upenn-embedded/final-project-s26-t2/README.md

Review Assignment Due Date (https://classroom.github.com/a/-Acvnhrq)

# Final Project

**Team Number: T2**

**Team Name:**

| Team Member Name | Email Address |
| --- | --- |
| Marko Mijatovic  | markomij@seas.upenn.edu |
| Devan Malik | devmalik@seas.upenn.edu |
| Kim Huang | huangkim@seas.upenn.edu |
| Victor Wanjohi | vwanjohi@seas.upenn.edu |

**GitHub Repository URL:  [https://github.com/upenn-embedded/final-project-s26-t2]([https://github.com/upenn-embedded/final-project-s26-t2]())**

**GitHub Pages Website URL:** https://devmalik771.github.io/Friendly_Fire/

## Final Project Proposal

### 1. Abstract

This project is a self-contained infrared laser tag system built around two ATmega328PB microcontrollers running bare-metal C. The system consists of a handheld blaster that transmits coded IR packets, a wearable vest that detects and validates hits with audiovisual feedback, and a Bluetooth-linked web application that serves as a referee console for match control and live scoring. The blaster features an LCD display (SPI) for ammo tracking, an MPU6050 accelerometer (I2C) enabling a shake-to-reload gesture, and sound effects via a piezo buzzer. The vest uses multiple IR receivers for coverage, RGB LEDs for hit and health feedback, and communicates match state to the web app over BLE. Together, the system enables a full match loop: start, play, elimination, winner declaration, and reset.

### 2. Motivation

Laser tag is a proven recreational concept, but commercial systems are expensive, proprietary, and offer no insight into the engineering behind them. This project recreates a fully functional laser tag experience from scratch using embedded systems principles, providing a hands-on application of IR communication, real-time firmware state machines, serial peripherals, and wireless connectivity. The project is interesting because it integrates multiple complex subsystems (shooting, hit detection, game logic, wireless comms, and a user-facing web interface) into a single playable product. The intended purpose is a two-player laser tag demo that can run a complete match cycle in under two minutes, showcasing real-time embedded system design at the ESE 3500 final demo day.

### 3. System Block Diagram



The system is composed of three subsystems communicating through IR and BLE:

Blaster (MCU 1 — ATmega328PB): Trigger and reload buttons (GPIO with internal pull-ups and pin-change interrupts), IR LED emitter driven through an NPN transistor (2N2222) switching 100 mA, modulated at 38 kHz via Timer1 output compare, SPI-driven ST7735 LCD breakout (128x160, onboard 3.3V level shifter), MPU6050 IMU breakout over I2C at 400 kHz (onboard LDO and level shifter for 5V-safe operation), piezo buzzer (Timer0 PWM), and a shoot-indicator LED with 220-ohm current-limiting resistor. Powered by a USB power bank providing 5V directly (no voltage regulator needed). 100 nF decoupling capacitors on MCU VCC pins.

Vest (MCU 2 — ATmega328PB): Two TSOP38238 IR receivers (5V-tolerant output, connected via pin-change interrupts for hit detection), WS2812B RGB LED strip (5V, 800 kHz data line), piezo buzzer (Timer2 PWM), and an HM-10 BLE module (3.3V logic) connected through a bidirectional logic level shifter on UART TX/RX lines at 9600 baud. The vest MCU runs game state logic (health tracking, invulnerability windows, elimination detection) and reports status to the web app via BLE. Powered by a USB power bank providing 5V directly. 100 nF decoupling capacitors on MCU VCC pins.

Web App (Referee Console): A browser-based application using the Web Bluetooth API that connects to the vest's BLE module. Provides match start/reset commands and displays live player health, ammo (relayed), hit events, and winner/loser at match end.

Communication Protocols

IR (Gun → Vest): 38 kHz modulated carrier with NEC-style packet encoding (preamble + shooter ID + team ID + CRC)

SPI (MCU 1 → LCD): ST7735 display driven over hardware SPI

I2C (MCU 1 → MPU6050): Accelerometer/gyroscope for shake-to-reload gesture detection on the blaster

UART (MCU 2 → HM-10 BLE): Serial link at 9600 baud through a bidirectional 5V/3.3V logic level shifter

GPIO + Interrupts: Button inputs (trigger, reload), IR receiver hit detection via pin-change interrupts

Topics Covered

Timers: PWM for IR carrier generation (38 kHz), buzzer tones, and LED brightness/patterns

Interrupts: Button debouncing, IR receiver packet detection, timer overflow for game timing

Serial Communication (SPI + I2C + UART): LCD display over SPI, MPU6050 accelerometer over I2C, BLE module over UART (satisfies I2C/SPI requirement with both protocols)

(Advanced) Wireless Communication: IR shot protocol design + BLE connectivity for remote match control

### 4. Design Sketches

#### Blaster



Handheld enclosure (3D printed or laser-cut) housing the ATmega328PB on perfboard, IR LED at the barrel tip driven by a 2N2222 NPN transistor, trigger and reload buttons on the grip, an ST7735 LCD breakout on the back face visible to the shooter, an MPU6050 IMU breakout mounted inside for shake-to-reload detection, a piezo buzzer, and a shoot-indicator LED. Powered by a USB power bank (5V direct, no regulator needed). Decoupling capacitors on all IC power pins.

#### Vest



A fabric vest or harness with 3D-printed/laser-cut mounting points for two IR receivers (front and back), WS2812B RGB LEDs for hit feedback visible to other players, a piezo buzzer for audio cues, and a small enclosure for the ATmega328PB, bidirectional level shifter, and HM-10 BLE module. Powered by a USB power bank (5V direct).



#### Manufacturing

3D printing (Tangen Hall / RPL): blaster enclosure, vest sensor mounts

Laser cutting (RPL): potential flat panels for enclosure sides, vest backing plate

### 5. Software Requirements Specification (SRS)

**5.1 Definitions, Abbreviations**

IR: Infrared. BLE: Bluetooth Low Energy. CRC: Cyclic Redundancy Check. PWM: Pulse Width Modulation. SPI: Serial Peripheral Interface. I2C: Inter-Integrated Circuit. UART: Universal Asynchronous Receiver-Transmitter. IMU: Inertial Measurement Unit. HRS: Hardware Requirements Specification. LCD: Liquid Crystal Display. MCU: Microcontroller Unit.e

**5.2 Functionality**

| ID | Description |
| --- | --- |
| SRS-01 | The blaster firmware shall transmit a valid IR shot packet within 50 ms of a trigger press, containing a preamble, shooter ID (4 bits), team ID (2 bits), and CRC-8 checksum. |
| SRS-02 | The blaster firmware shall enforce a minimum inter-shot interval of 500 ms (±50 ms) to prevent shot spamming, blocking trigger input during the cooldown period. |
| SRS-03 | The blaster firmware shall decrement the ammo counter on each valid shot and block firing when ammo reaches zero. The LCD shall update the displayed ammo count within 100 ms of a shot. |
| SRS-04 | The reload mechanic shall support two modes: (a) a continuous 10-second (±0.5 s) button hold, or (b) a shake-to-reload gesture detected by the MPU6050 (see SRS-09). For button reload, releasing early shall cancel the attempt. Successful reload via either method shall reset ammo to the maximum value. |
| SRS-05 | The vest firmware shall validate incoming IR packets by checking carrier frequency presence, correct packet framing, and CRC integrity. Invalid packets shall be discarded without affecting game state. |
| SRS-06 | Upon a valid hit, the vest firmware shall enforce an invulnerability window of 2 seconds (±200 ms) during which additional hits are ignored, preventing double-counting from a single shot burst. |
| SRS-07 | The vest firmware shall transmit updated player status (health, eliminated flag) to the BLE module via UART within 500 ms of any game state change (hit received, elimination, reset). |
| SRS-08 | Upon receiving a RESET command from the web app via BLE, both MCUs shall return to their initial ready state (full health, full ammo, ALIVE status) within 1 second. |
| SRS-09 | The blaster firmware shall read the MPU6050 accelerometer via I2C at a minimum rate of 20 Hz and detect a shake-to-reload gesture when acceleration exceeds 2g on any axis for at least 3 consecutive samples. The gesture shall initiate the reload sequence as an alternative to the button hold. |

### 6. Hardware Requirements Specification (HRS)

**6.1 Definitions, Abbreviations**

FOV: Field of View. dB: Decibels. SNR: Signal-to-Noise Ratio. PCB: Printed Circuit Board. LDO: Low Dropout Regulator. NPN: Negative-Positive-Negative (transistor type). BSS138: N-channel MOSFET used in level shifter circuits.

**6.2 Functionality**

| ID | Description |
| --- | --- |
| HRS-01 | The IR emitter circuit shall use an NPN transistor (2N2222 or equivalent) to drive a 940 nm IR LED at 100 mA, producing a 38 kHz (±1 kHz) modulated carrier signal detectable by a TSOP38238 receiver at a minimum range of 3 meters in indoor ambient lighting conditions. |
| HRS-02 | The vest shall incorporate a minimum of two IR receiver modules (TSOP38238 or equivalent) providing front and rear hit detection coverage. |
| HRS-03 | The LCD display (ST7735 or equivalent, minimum 128x128 pixels, SPI interface) shall be visible to the player under normal indoor lighting and update at a minimum refresh rate of 5 fps for game state information. |
| HRS-04 | The HM-10 BLE module (3.3V logic) shall connect to the vest MCU (5V logic) through a bidirectional logic level shifter on UART TX/RX lines at 9600 baud, and sustain a BLE link to the web app at distances up to 5 meters indoors.7. Bill of Materials (BOM) |
| HRS-05 | The piezo buzzers on both the blaster and vest shall produce audible feedback at a minimum of 65 dB at 30 cm distance, with distinct tones for shot fired, hit received, elimination, and reload complete events.HRS-06**HRS-06****HRS-06** |
| HRS-06 | The blaster and vest shall each be powered by USB power banks providing 5V directly, with a minimum capacity of 5000 mAh supporting at least 60 minutes of continuous gameplay without requiring a recharge. |
| HRS-07 | Each ATmega328PB shall operate at 16 MHz with a 5V supply from the USB power bank. Each MCU VCC pin shall have a 100 nF ceramic decoupling capacitor to filter high-frequency noise. Total system current draw per subsystem shall not exceed 500 mA. |
| HRS-08 | The LED feedback system on the vest shall provide visually distinct patterns for hit (flash), low health (pulsing), and eliminated (solid or rapid flash) states, visible from at least 2 meters in normal indoor lighting. |
| HRS-09 | The MPU6050 IMU shall be mounted rigidly inside the blaster enclosure and communicate with the ATmega328PB over I2C at 400 kHz. The accelerometer shall be configured for a ±4g range with 16-bit resolution. |

### 7. Bill of Materials (BOM)

| Component | Part / Model | Qty | Unit Cost | Vendor | Purpose |
| --- | --- | --- | --- | --- | --- |
| Microcontroller | ATmega328PB | 2 | Kit | Lab / Kit | Blaster + Vest MCUs |
| LCD Display | ST7735 1.8" TFT breakout (SPI, onboard level shifter) | 1 | ~$10 | Adafruit | Blaster ammo display |
| IMU | MPU6050 breakout (I2C, onboard LDO + level shifter) | 1 | ~$4 | Adafruit | Shake-to-reload gesture |
| IR Emitter LED | 940nm IR LED (5mm) | 2 | ~$1 | Adafruit / DigiKey | Shot transmission |
| NPN Transistor | 2N2222 + 100Ω base resistor | 2 | ~$0.50 | Lab / DigiKey | IR LED driver (100mA) |
| IR Receiver | TSOP38238 (38kHz) | 3–4 | ~$2 ea | Adafruit / DigiKey | Vest hit detection |
| BLE Module | HM-10 (3.3V UART) | 1 | ~$6 | Amazon / Adafruit  | Vest-to-web-app link |
| Logic Level Shifter | Bi-dir 3.3V/5V (BSS138) | 1 | ~$4 | Adafruit | UART level shift for HM-10 |
| Piezo Buzzer | Passive piezo | 2 | ~$1 ea | Adafruit / DigiKey | Audio feedback |
| RGB LEDs | WS2812B strip | 1 strip | ~$8 | Adafruit | Vest hit/health feedback |
| Buttons | Tactile pushbuttons | 3–4 | ~$0.50 ea | Lab / DigiKey | Trigger, reload, reset |
| USB Power Banks | 5V 2A output, 5000mAh+ | 2 | ~$8 ea | Amazon | 5V power for each unit |
| Passives + Misc | 100nF caps, 220Ω/100Ω resistors, perfboard, wires | — | ~$10 | Lab / Kit | Decoupling, current limiting, assembly |

Estimated Total: ~$70–$90

### 8. Final Demo Goals

On demo day, the system will be demonstrated as a live two-player laser tag match at a lab station in Detkin Lab. One team member will wear the vest and another will hold the blaster while someone else operates the web app on a laptop as the referee. The demo will follow this sequence:

* Referee starts the match from the web app
* Player fires the blaster at the vest, showing IR hit detection, LCD ammo decrement, and vest LED/buzzer feedback in real time
* Player runs out of ammo and performs the shake-to-reload gesture (or 10-second button hold as fallback)
* Vest player is eliminated (health reaches zero), vest shows elimination feedback, web app declares result
* Referee resets the match from the web app, all devices return to ready state

#### Constraints

* Demo will be conducted at a single lab station (no outdoor space required)
* IR range of ~3 meters is sufficient for the indoor demo area
* All components are USB power bank powered for portability (no wall outlet dependency)

### 9. Sprint Planning

**Sprint Milestones**

| Week | Milestone | Key Tasks |
| --- | --- | --- |
| Mar 16–22 | Parts Ordering + Prototyping | Finalize BOM, order parts, begin breadboard prototyping of IR emitter/receiver pair, set up ATmega328PB dev environments |
| Mar 23–30 | Subsystem Bringup | IR TX/RX communication working, LCD displaying over SPI, BLE module pairing with test web page, buzzer tones verified. Parts ordering meeting with Account Manager. |
| Mar 30–Apr 3 | Sprint 1: Core Firmware | Blaster state machine (ammo, fire, reload), vest state machine (health, hits, invulnerability). IR packet protocol (encode/decode + CRC). Sprint Review #1. |
| Apr 4–10 | Sprint 2: Integration | Integrate blaster and vest for end-to-end shot-hit cycle. BLE commands from web app controlling game state. Begin mechanical enclosure work. Sprint Review #2. |
| Apr 11–17 | MVP Demo | All electronics and firmware functional at basic level. Full match loop working (start, shoot, hit, eliminate, reset). Enclosures in progress. MVP Demo on Apr 17.  |
| Apr 18–24 | Polish + Final Demo | Finalize enclosures, polish web app UI, tune IR range/reliability, stress test full system. Final Demo Apr 24. |
| Apr 25–27 | Final Report | Record demo video, write validation results for SRS/HRS, complete GitHub Pages website. Due Apr 27. |

| Member | Primary Responsibility | Secondary |
| --- | --- | --- |
| Kim | Blaster firmware (state machine, IR TX, LCD driver) | IR protocol co-design |
| Devan  | Vest firmware (hit detection, game logic, BLE UART) | IR protocol co-design |
| Marko  | Web app (BLE integration, match UI, referee controls) | BLE protocol definition, integration testing |
| Victor | Hardware & mechanical (circuits, power, enclosures, vest) | Integration, soldering, 3D print / laser cut |

**This is the end of the Project Proposal section. The remaining sections will be filled out based on the milestone schedule.**

## Sprint Review #1

### Last week's progress

**Blaster (MCU 1) — Kim & Victor:**

- Trigger and reload buttons wired with GPIO and internal pull-ups, confirmed functional on breadboard.
- IR emitter circuit assembled: 940nm IR LED driven through 2N2222 NPN transistor, switching ~100mA off a GPIO-controlled base pin.
- ATmega328PB dev environment set up and running bare-metal C on the blaster MCU.
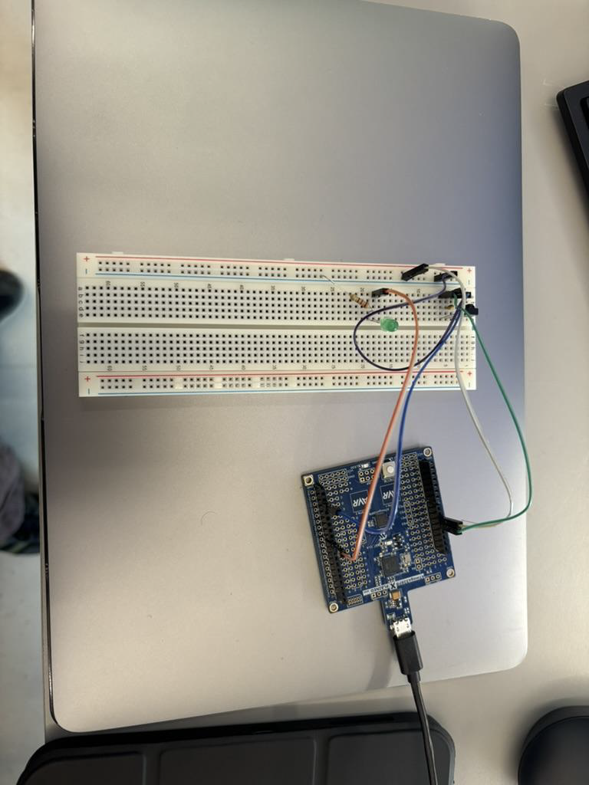
[picture p1: image/README/1776045404980.png]
  

**Vest (MCU 2) — Devan & Marko:**

- TSOP38238 IR receiver wired with 100nF decoupling cap on VCC (required by datasheet for stable operation). Confirmed it detects 38kHz modulated IR from the blaster emitter.
- Basic hit detection prototype working: LED lights on valid IR detection via pin-change interrupt.
- Vest ATmega328PB brought up on the breadboard.

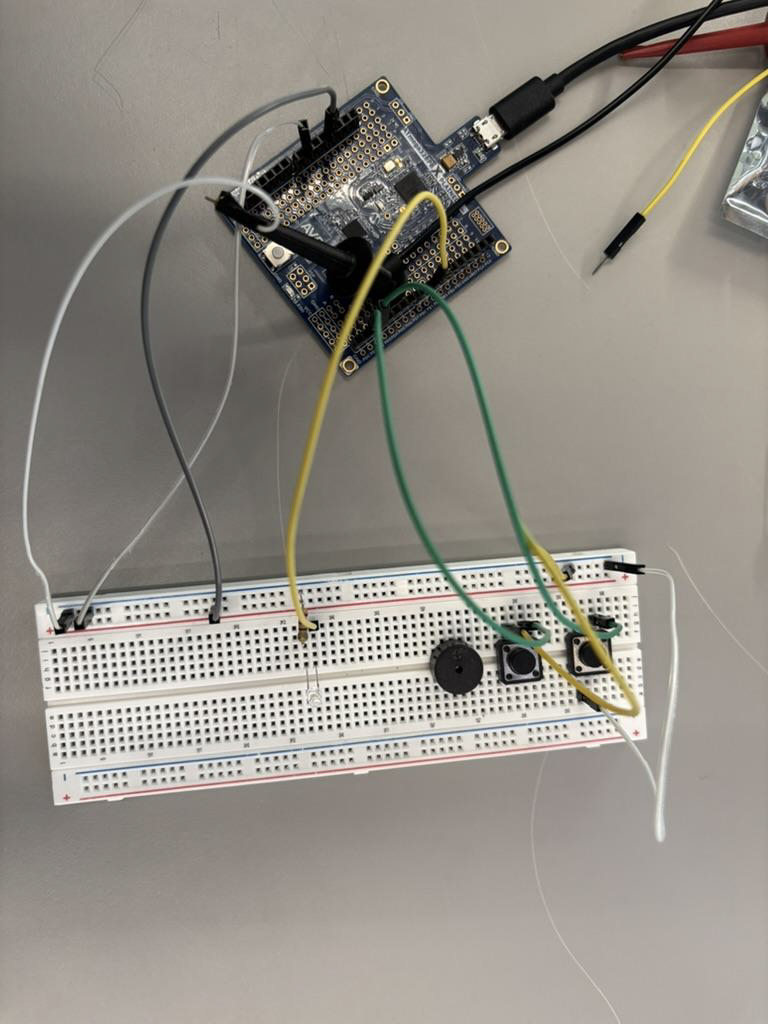
[picture p2: image/README/1776045441887.png]


Design Change — BLE → Feather ESP32:

- Pivoted from the HM-10 BLE module to an Adafruit Feather ESP32 for the wireless link between the vest and web app. The Feather gives us Wi-Fi + BLE flexibility and a more mature software ecosystem for the web app side, while still only serving as a comms module (no application logic — all game logic remains on the ATmega328PB per course restrictions).

### Current state of project

Core subsystems are individually coming online on breadboards. IR TX → RX link is proven at the physical layer. The BLE-to-Feather pivot is a scope adjustment but doesn't affect the ATmega firmware architecture — the Feather just replaces the HM-10 on the UART lines.

Hardware status: All critical components are in hand (ATmega328PBs, TSOP38238s, IR LEDs, 2N2222s, ST7735 LCD, MPU6050). Feather ESP32 is on hand. No outstanding part orders blocking progress.

Risk: IR packet reliability at 3m range hasn't been tested yet — that's a key validation target for next sprint.

### Next week's plan

| Task | Time  | Owner | Definition of Done |
| --- | ----- | --- | --- |
| Feather ESP32 + Web App BLE link | 2-4 h | Marko | Feather pairs with browser via Web Bluetooth API; can send/receive test strings bidirectionally |
| ST7735 LCD over SPI | 1-2 h | Kim | LCD displays static ammo count on blaster MCU |
| MPU6050 I2C bringup | 1-2 h | Kim/Devan | Read raw accelerometer values over I2C at 400kHz, print to serial |
| Piezo buzzer tones | 10 m  | Victor | Timer-driven PWM produces distinct tones for shot/hit/reload events |
| Migrate to circuit boards (perfboard) | 2 h | Victor/Devan/Marko | Blaster and vest circuits soldered on perfboard, off breadboard |

## Sprint Review #2

### Last week's progress

##### Blaster (MCU 1)

- Successfully demonstrated reload action sequences to the account manager.

##### Vest (MCU 2)

- Implemented piezo buzzer overtone generation via timer-driven PWM.
- Source code committed and pushed to the team GitHub repository.
- Successfully demonstrated distinct audio tones for shot, hit, and reload events to the account manager during lab session.
- Feather pairs with browser via Web Bluetooth API; can send/receive test strings bidirectionally

### Current state of project

### Next week's plan

## MVP Demo

### 1. Block Diagram:

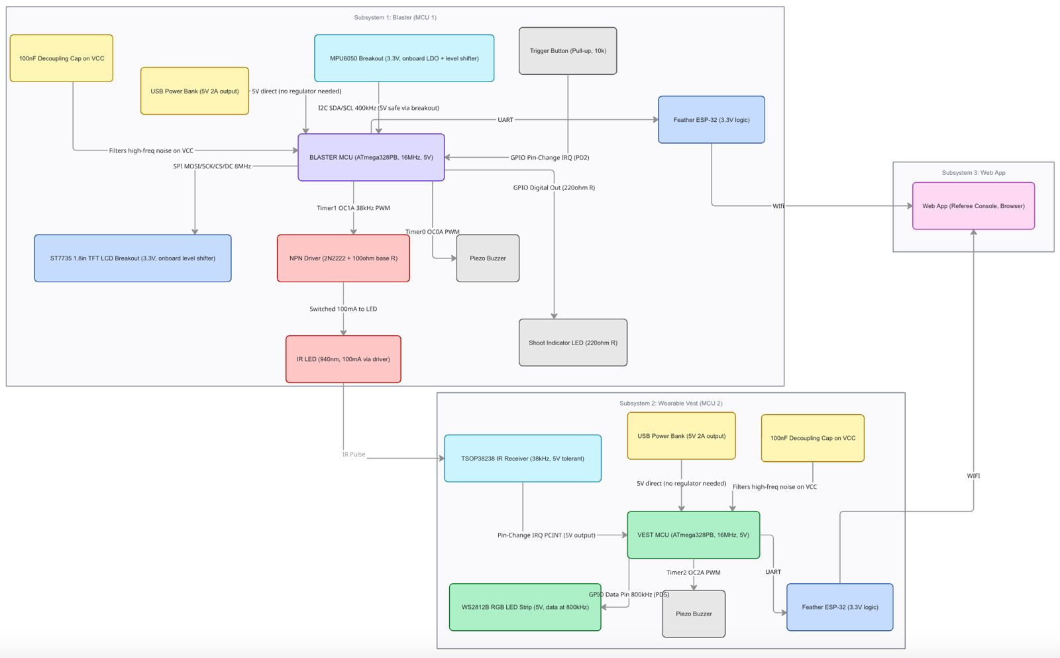
[picture p3: image/README/1777425051182.png]


Two ATmega328P MCUs,  one handles user input, LCD feedback, and IR transmission; the other detects incoming IR and signals a hit via LED flash.

### 2. Explain your firmware implementation, including application logic and critical drivers you've written.

We established UART communication between the main MCU and the Feather module, defined a simple message protocol, and enabled remote reset commands and periodic status updates to the web app.

We implemented a state machine to manage gameplay states (idle, firing, hit detection, reload, reset) and non-blocking timing via timers and interrupts to allow concurrent subsystem operation.

At demo, the system was fully playable ,a user could fire the blaster, register hits on the vest, receive feedback, and reset the game through the web interface.

### 3. Demo your device.

1. Power on → LCD shows `READY`, ammo = 12
2. Pull trigger → LCD shows `FIRED`, ammo decrements
3. Fire until empty → LCD shows `EMPTY`, further triggers blocked
4. Press reload → LCD shows `RELOADING` (1.5s) → resets to `READY`, ammo = 12
5. Fire at receiver → hit LED flashes 200ms

### 4. Have you achieved some or all of your Software Requirements Specification (SRS)?

| Requirement | Status |
| --- | --- |
| Display ammo count on startup | Done |
| Decrement ammo on valid trigger  | Done |
| Block firing at 0 ammo | Done |
| Show `EMPTY` when out of ammo  | Done |
| Show `RELOADING` during reload | Done |

### 5. Have you achieved some or all of your Hardware Requirements Specification (HRS)?

| Requirement | Status |
| --- | --- |
| IR LED transmitter on PC0 | Done |
| SPI LCD (ST7735) integrated  | Done |
| Trigger button on PD2 | Done |
| Reload button on PD3 | Done |
| TSOP38238 IR receiver on PD2 | Done |
| Hit indicator LED on PB0 | Done |

### 6. Show off the remaining elements that will make your project whole: mechanical casework, supporting graphical user interface (GUI), web portal, etc.

- **Mechanical casework** — rectangular blaster housing

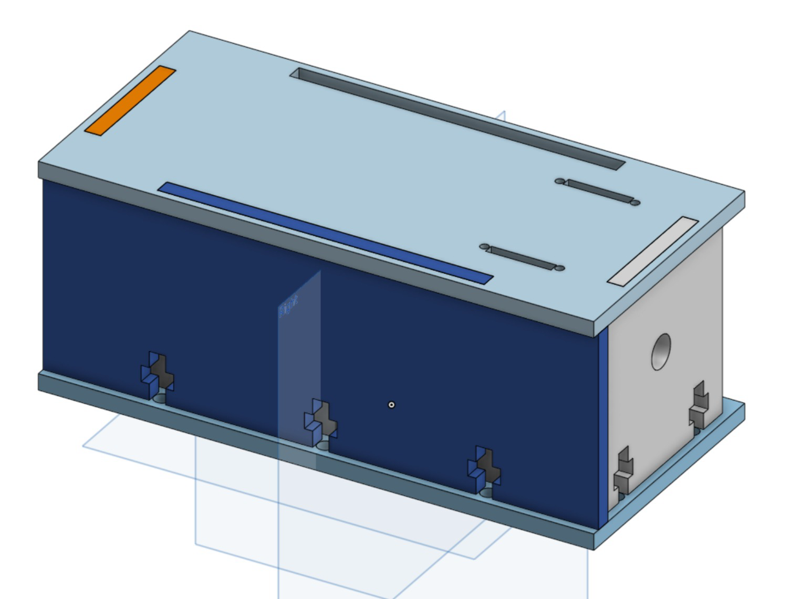
[picture p4: image/README/1776835262604.png]
  

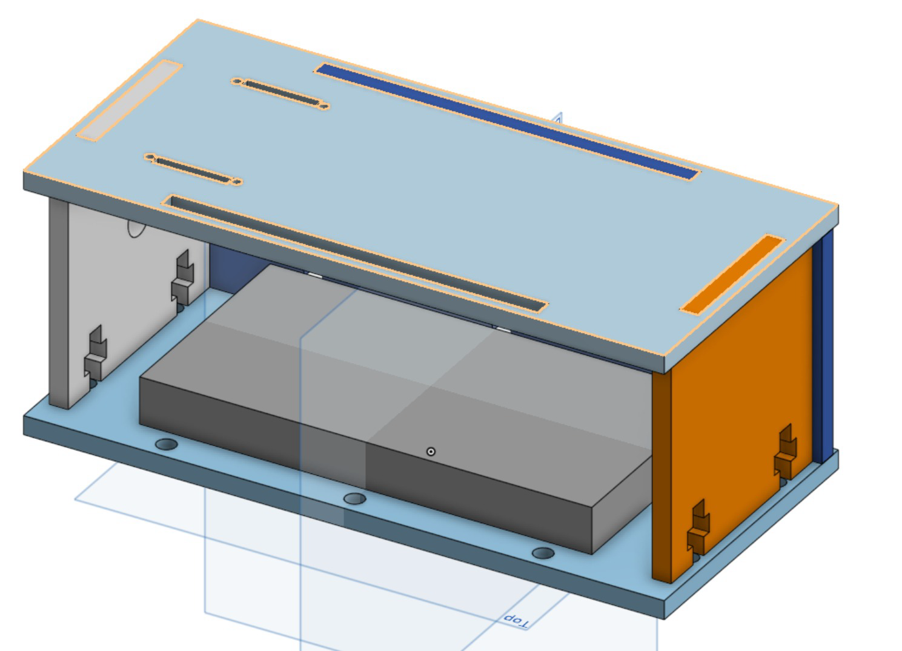
[picture p5: image/README/1776835277516.png]
  

### 7. What is the riskiest part remaining of your project?

During integration and migrating parts from breadboards to perfboards, some functionality might break down. We expect to solve all bugs in good time.

## Final Report

Don't forget to make the GitHub pages public website!
If you’ve never made a GitHub pages website before, you can follow this webpage (though, substitute your final project repository for the GitHub username one in the quickstart guide):  [https://docs.github.com/en/pages/quickstart](https://docs.github.com/en/pages/quickstart)

## 1. Video

https://drive.google.com/drive/folders/1jIbaAgMy6JAKm02dPGXfAoZNbYtTDbEu?usp=drive_link

### 2. Images

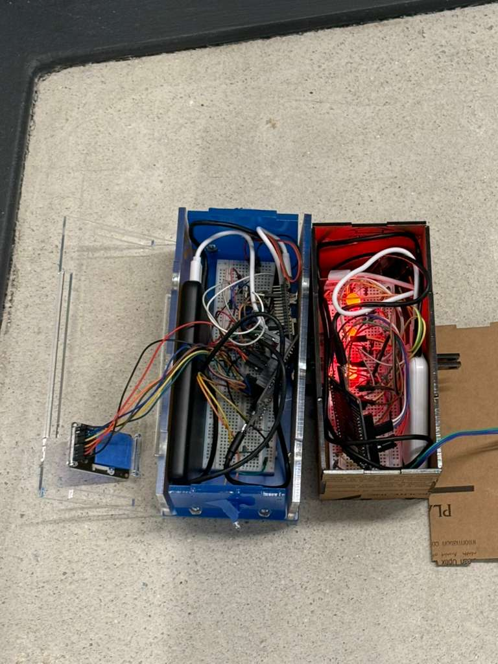
[picture p6: image/README/ese 350 pic 1.jpeg]

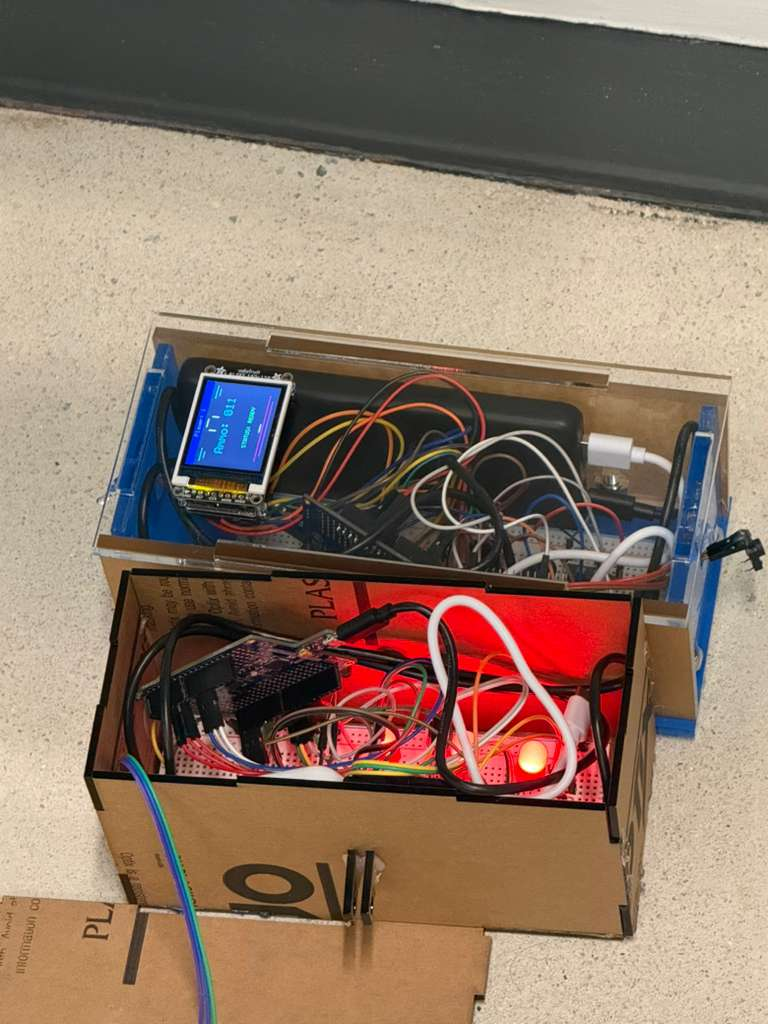
[picture p7: image/README/ese 350 pic 2.jpeg]

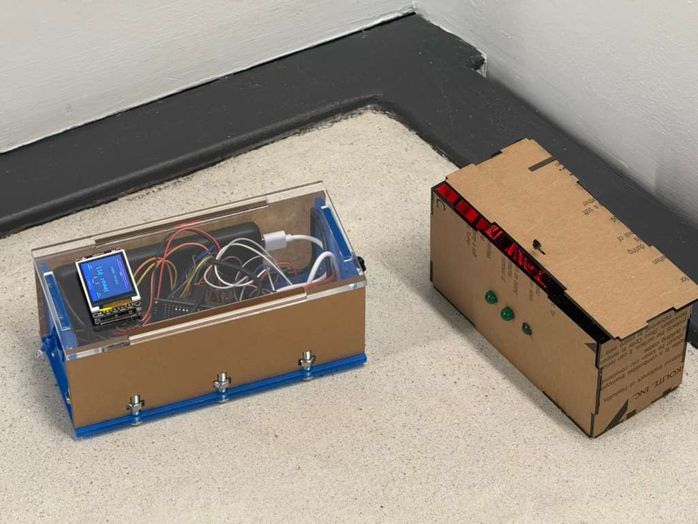
[picture p8: image/README/ese 350 pic 3.jpeg]

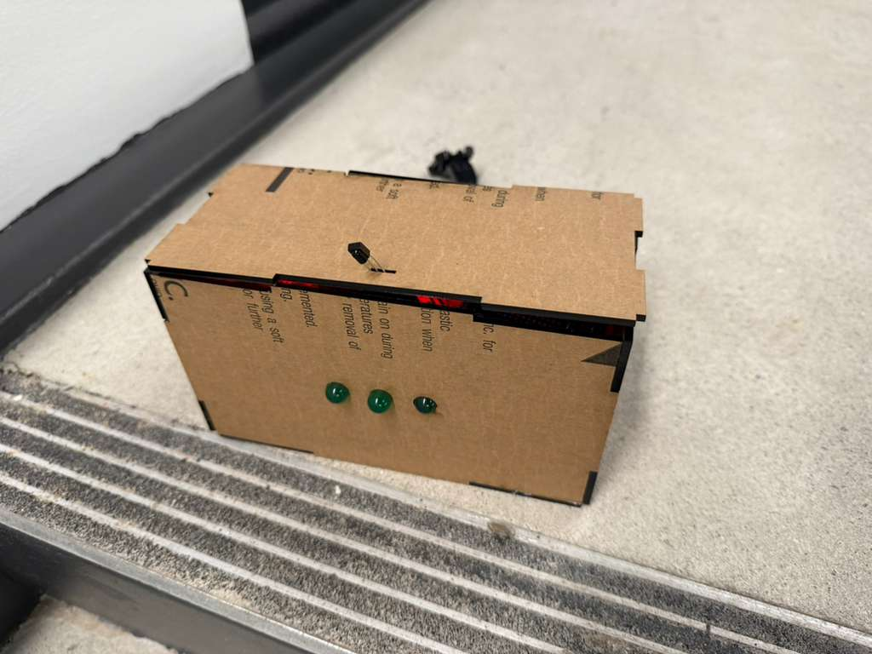
[picture p9: image/README/ese 350 pic 4.jpeg]


### 3. Results

#### 3.1 Software Requirements Specification (SRS) Results

- *SRS 01:* The blaster firmware activates the IR LED for a duration of 0.5 seconds immediately after a valid trigger press is detected, ensuring that each shot produces a consistent and clearly identifiable output signal. This timing is controlled precisely in software so that every trigger event results in uniform LED behavior regardless of user input speed.
- *SRS 02:* The blaster firmware enforces a minimum inter-shot interval of 500 ms (±50 ms) to prevent excessive firing or spamming. During this cooldown period, any additional trigger inputs are ignored, and the system only re-enables firing once the interval has fully elapsed, ensuring consistent gameplay pacing and system reliability.
- *SRS 03:* The blaster firmware decrements the ammo counter each time a valid shot is fired and prevents any further firing once the ammo count reaches zero. The LCD display updates the visible ammo count within 100 ms of each shot, providing immediate feedback to the user and ensuring the displayed value always reflects the true internal state.
- *SRS 04:* The reload mechanic is implemented exclusively through a shake-to-reload gesture detected by the MPU6050 accelerometer. When a valid shake pattern is identified, the system initiates a reload sequence that restores the ammo count to its maximum value, providing a responsive and intuitive method for reloading without requiring button input.
- *SRS 05:* The vest firmware transmits updated player status information, including current health and elimination state, to the BLE module via UART within 500 ms of any change in game state. This ensures that external systems, such as a connected web application, receive timely and accurate updates reflecting in-game events.
- *SRS 06:* When a RESET command is received from the web application via BLE, both microcontrollers transition back to their initial ready state within 1 second. This reset restores full health, full ammo, and ALIVE status, ensuring the system is quickly ready for a new game session.
- *SRS 07:* The blaster firmware continuously reads acceleration data from the MPU6050 via I2C at a minimum sampling rate of 20 Hz. A shake-to-reload gesture is detected when acceleration exceeds 2g on any axis for at least three consecutive samples, at which point the system reliably triggers the reload sequence.

#### 3.2 Hardware Requirements Specification (HRS) Results

- *HRS 01:* The IR emitter circuit uses an NPN transistor to drive a 940 nm IR LED at approximately 50 mA, generating a signal that can be reliably detected by a TSOP38238 receiver at a minimum range of 3 meters under typical indoor lighting conditions.
- *HRS 02:* The vest incorporates at an IR receiver modules positioned to provide both front hit detection coverage, ensuring consistent detection.
- *HRS 03:* The LCD display ST7735 is clearly visible to the player under normal indoor lighting conditions and updates at a minimum refresh rate of 5 frames per second to reflect current game state information such as ammo.
- *HRS 04:* A Feather ESP-based microcontroller system is used to handle wireless communication with the web application, maintaining a stable connection and enabling reliable transmission of game state data within typical indoor operating distances of up to 5 meters.
- *HRS 05:* A piezo buzzer on the blaster provides clear and audible feedback at a minimum of 65 dB measured at 30 cm, with distinct tones corresponding to events such as firing, reload completion, and no ammo.
- *HRS 06:* The blaster and vest are each powered by USB power banks supplying 5V directly, with a minimum capacity of 5000 mAh to support at least 60 minutes of continuous gameplay without requiring recharge.
- *HRS 07:* Each ATmega328PB operates at 16 MHz with a regulated 5V supply, and each MCU includes a 100 nF ceramic decoupling capacitor across VCC to filter high-frequency noise; the total current draw per subsystem does not exceed 500 mA during normal operation.
- *HRS 08:* The vest includes a visual feedback system consisting of three LEDs that indicate the player’s remaining lives, with the number of illuminated LEDs decreasing by one for each valid hit until all lives are depleted; the LEDs are clearly visible from at least 2 meters under standard indoor lighting.

###### 4. Conclusion

This project was a successful end-to-end build, and we are satisfied with the final system. We were able to meet all of our hardware and software requirements, and the blaster–vest system functions reliably in gameplay. Throughout the process, we learned how to integrate multiple subsystems—microcontrollers, sensors, IR communication, and user feedback—into a cohesive embedded system, as well as how to debug issues that arise when moving from isolated components to a fully integrated design.
Several aspects of the project went particularly well. We are proud of achieving a fully working system that includes real-time interaction, reliable hit detection, and responsive user feedback. The shake-to-reload mechanism, IR detection, and overall gameplay loop all came together in a way that demonstrates strong system-level design and implementation. We also gained valuable experience working through the full engineering cycle, from prototyping on breadboards to attempting a more finalized physical build.
At the same time, we encountered challenges that required us to adjust our approach. We had unexpected issues with getting the LED to function consistently, which slowed progress and limited how much time we could dedicate to refinement. Additionally, transitioning from a controlled lab bench setup to a physical enclosure introduced new problems related to wiring stability and robustness that we had not fully anticipated. These obstacles highlighted the importance of designing for reliability early and testing under more realistic conditions sooner.
If we were to approach this project again, we would prioritize earlier integration and enclosure testing, along with cleaner wiring and more modular design practices. With more time, we would focus on polishing the physical build, improving durability, and making the system more visually clean and robust. We do wish we had been able to reach that level of refinement, and we recognize that early setbacks—particularly with the LED—limited our ability to fully realize the system’s potential.
As a next step, this project could be expanded by improving the enclosure design, enhancing robustness for extended use, and adding additional gameplay features such as more advanced scoring, networking capabilities, or expanded player interaction. Overall, this project was a valuable and rewarding experience that strengthened both our technical skills and our ability to manage and execute a complex engineering system.

## References
