upenn-embedded/final-project-s26-t2/(commit log)

2026-04-03 laser gune v1
2026-04-21 Add RGB LED control and hit detection functionality
    Implement RGB LED control with hit detection and life tracking.
